rotarybean/DoomCube/BTT Octopus v1.1/BTT Mini12864v1.png

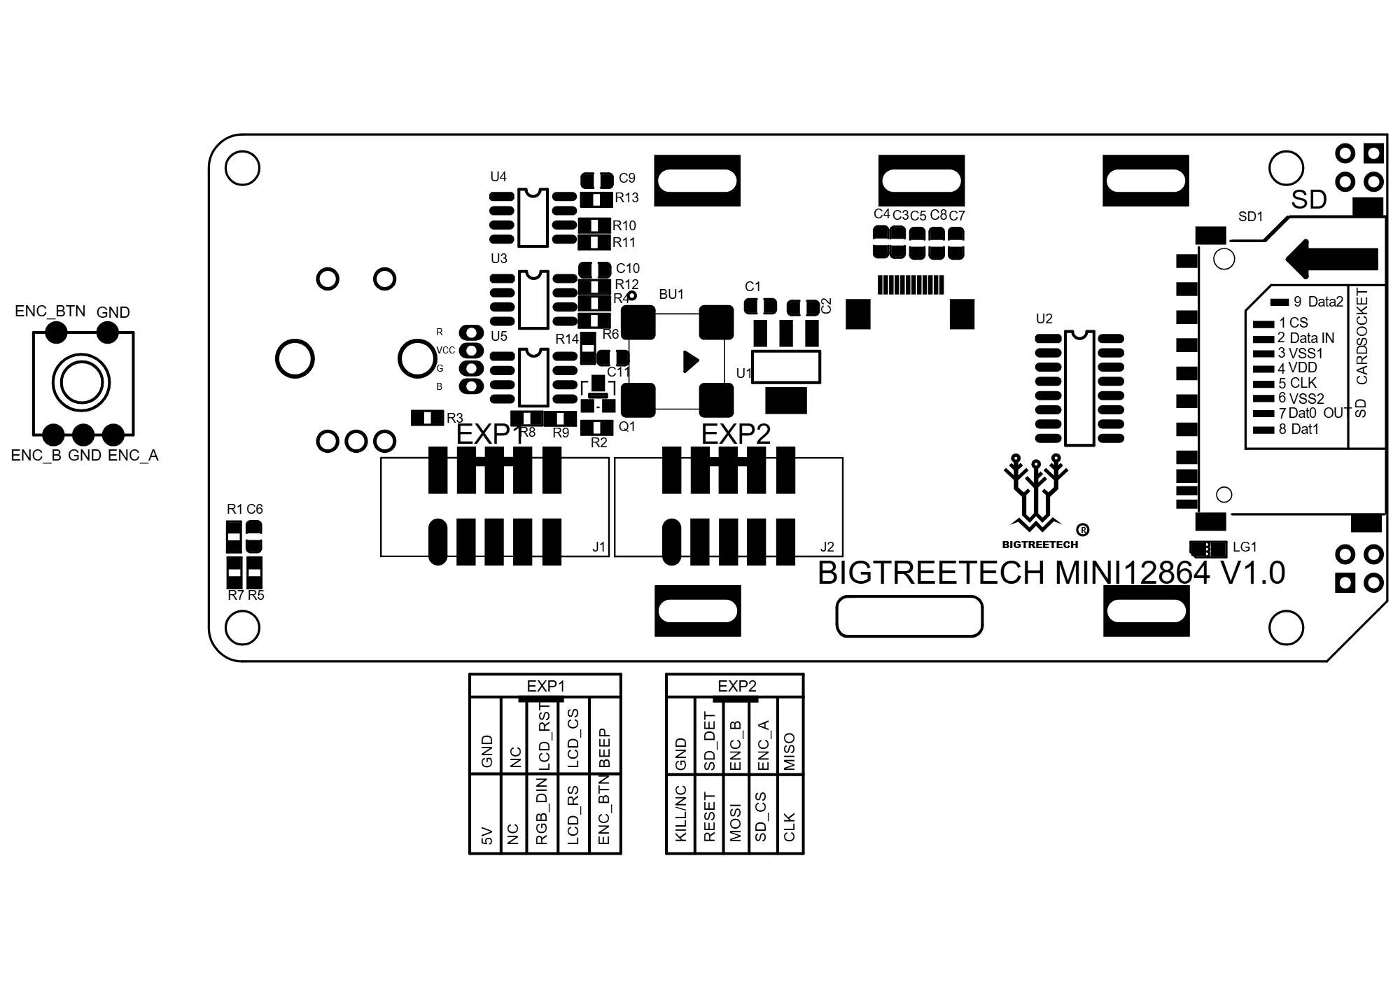
BTT Octopus v1.1/BTT Mini12864v1.png
