rotarybean/DoomCube/(list of files, drawings)

Other design files:
Doom Cube System Schematic.dsn
Kube-Aid Schematic R1.dsn
