rotarybean/DoomCube/(commit log)

2024-03-29 Delete Kube-Aid Schematic R1.dsn
    Replacing
    [Kube-Aid Schematic R1.dsn]
2024-03-29 Add files via upload
    Replacing the previous files which didn't include an actual pinout in text. Yay.
    [Kube-Aid Schematic R1.dsn]
2024-04-04 Add files via upload
    Operating System for Kube-Aid 360w 12v Power Supply Unit.
2024-04-22 Add files via upload
    Wiring schematic for SLI/MultiData interface; Revision 1
2025-04-08 Add files via upload
    current as of upload
    [printer.cfg]
2026-10-14 Initialize README.md for The Doom³ project
    Add detailed README for The Doom³ project including features, hardware overview, wiring, and getting started instructions.
